VedantGithub123/Operational-Amplifier-PID-Line-Follower/media/robot-photo.png

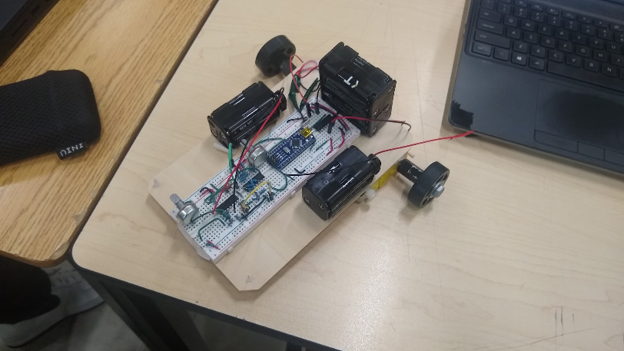
media/robot-photo.png
