VedantGithub123/Operational-Amplifier-PID-Line-Follower/report/report.docx

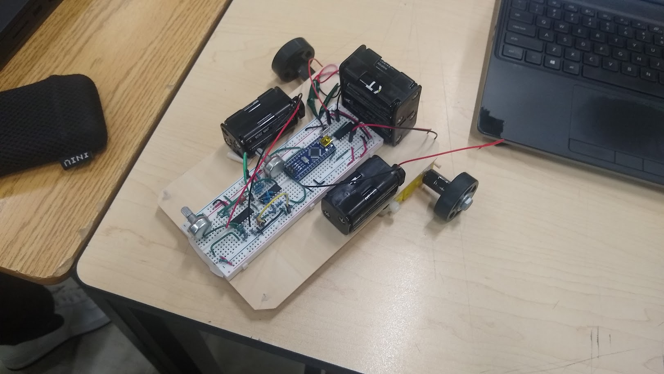
[picture p3: figure]
